xlair-dev/controller/v1/firmware/PROTOCOL.md

# Protocol V1

## フレーム形式

長さは常に 36 バイト。1 フレーム内のオフセットは以下の通り：

| Offset | Bytes | Name | Details |
| --- | ----- | --- | --- |
| 0 | 1 | `SYNC` | `0xFF` 固定 |
| 1 | 1 | `SEQ` | `0x00` - `0xFE`。送信予定スロットごとに `mod 255` で増加 |
| 2 | 1 | `VALID` | bit 0..3：各タッチ基板の I2C 読み出し成功。他 bit は 0 |
| 3 | 1 | `BUTTONS` | bit 0..6 は 7 個のボタン、bit 7 は常に 0。未接続は 0 |
| 4-35 | 32 | `SENSORS` | それぞれ `0x00` - `0xFE` の 32 電極分 |

- `SYNC` 以外の 35 バイトは必ず `0x00` - `0xFE` とする。
- `SEQ` は周期的な送信機会ごとに増える。送信バッファ不足などでフレームを送らなかった場合も進めるため、受信側は抜けた送信機会を推定できる。再起動時は `0` から始めてよい。
- フレームの境界は、`SYNC`、長さ 36 バイトで確定する。

## SENSORS

電極値は、CY8CMBR3108 の Difference Count を `uint8_t` に収めて送る。
各 CY8CMBR3108 は事前に 8 チャネルをボタンセンサーとして設定する。
`254` との min を取るなりして元データの `255` は `254` に丸める。

### 配置と順序

縦方向優先で、1 列につき「上 → 下」の順に番号を振る。

```
00  02  04  06  08  10  12  14  16  18  20  22  24  26  28  30
01  03  05  07  09  11  13  15  17  19  21  23  25  27  29  31
```

| 基板 | I2C address | `SENSORS` のインデックス | 列 |
| --- | --- | --- | --- |
| Slider 1 | `0x37` | `0..7` | `0..3` |
| Slider 2 | `0x38` | `8..15` | `4..7` |
| Slider 3 | `0x39` | `16..23` | `8..11`  |
| Slider 4 | `0x3A` | `24..31` | `12..15` |

各基板の 8 電極は同じ配線で、物理順 E1..E8 はそれぞれ CS3, CS2, CS7, CS6, CS4, CS5, CS0, CS1 に対応する。

### VALID

| Bit | 基板 | 対応アドレス |
| --: | --- | --- |
| 0 | Slider 1 | `0x37` |
| 1 | Slider 2 | `0x38` |
| 2 | Slider 3 | `0x39` |
| 3 | Slider 4 | `0x3A` |

- ビット `1`：フレームに使ったその基板の直近の I2C 読み出しと `SYNC_COUNTER0/1` の一致確認が成功した。
- ビット `0`：読み出しまたは一致確認に失敗した、またはまだ一度も成功していない。同期カウンタ不一致時のみ、その周期で1回再読する。再読も失敗した場合は次の周期で読み直す。
- 失敗した基板の 8 個の `SENSORS` は すべて `0` にする。PC は `VALID = 0` の領域を「非タッチ」と解釈してはならない。
- `VALID = 1` は IC 内部で新しい測定が完了したことを保証しない。読み出しが成功しても、前回と同じ測定値が返ることがある。

## BUTTONS

1 が押下中、0 が解放中。
電気的な active-low / active-high の違いは Pico 側で吸収する。

| Bit | 割り当て |
| --: | --- |
| 0 | ゲームボタン 0 |
| 1 | ゲームボタン 1 |
| 2 | ゲームボタン 2 |
| 3 | ゲームボタン 3 |
| 4 | メンテナンスボタン 0 |
| 5 | メンテナンスボタン 1 |
| 6 | メンテナンスボタン 2 |
| 7 | 常に 0 |

## 送信タイミング

- v1 の初期実装は約 5 ms ごとに最新の状態を 1 フレーム送信する。
- タッチ IC 4 枚は I2C で読み出し、ボタンは GPIO で取得する。
- USB 出力が詰まった場合は状態をキューに積み上げない。最新状態を優先し、途中のフレームは破棄してよい。
