xlair-dev/controller/v1/kicad-lib/3dmodels/WS2812B-4020.step

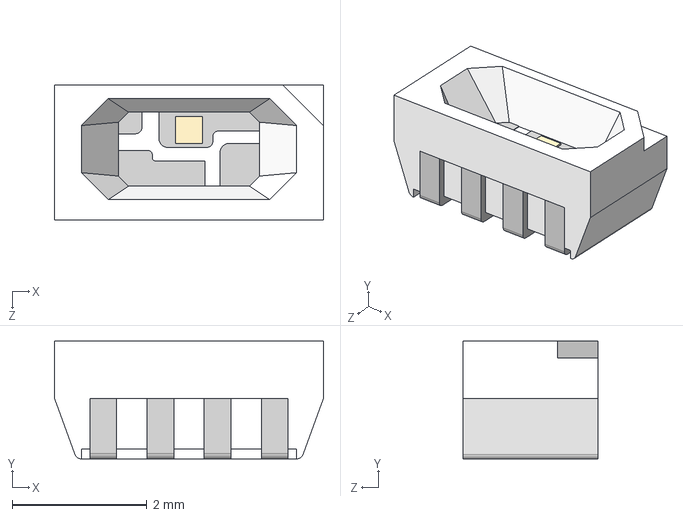
[picture p1: CAD file, 2026-08-24, an earlier design]
v1/kicad-lib/3dmodels/WS2812B-4020.step
4.00 x 1.75 x 2.00 mm
