xlair-dev/controller/v1/pcb/v1.kicad_pcb

## KiCad design v1/pcb/v1.kicad_pcb (2026-10-13, an earlier design)

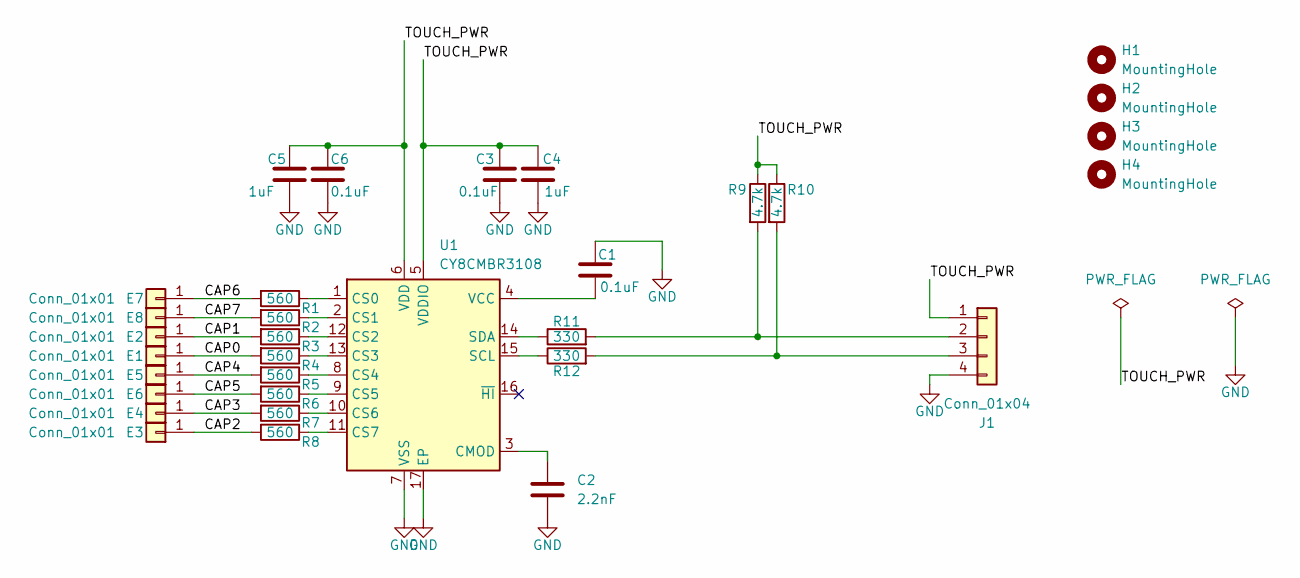
[picture p2: schematic v1.kicad_sch]

Parts:
C1, C3, C5: 0.1uF; C_0603_1608Metric
C2: 2.2nF; C_0603_1608Metric
C4, C6: 1uF; C_0603_1608Metric
E1, E2, E3, E4, E5, E6, E7, E8: Conn_01x01; TouchPad
H1, H2, H3, H4: MountingHole; MountingHole_3.2mm_M3
J1: Conn_01x04; JST_XH_B4B-XH-A_1x04_P2.50mm_Vertical
R1, R2, R3, R4, R5, R6, R7, R8: 560; R_0603_1608Metric
R9, R10: 4.7k; R_Axial_DIN0207_L6.3mm_D2.5mm_P10.16mm_Horizontal
R11, R12: 330; R_0603_1608Metric
U1: CY8CMBR3108; QFN-16-1EP_3x3mm_P0.5mm_EP1.7x1.7mm

Connections:
/CAP0: E1.1 (Pin_1_1), R4.2
/CAP1: E2.1 (Pin_1_1), R3.2
/CAP2: E3.1 (Pin_1_1), R8.2
/CAP3: E4.1 (Pin_1_1), R7.2
/CAP4: E5.1 (Pin_1_1), R5.2
/CAP5: E6.1 (Pin_1_1), R6.2
/CAP6: E7.1 (Pin_1_1), R1.2
/CAP7: E8.1 (Pin_1_1), R2.2
/TOUCH_PWR: C3.1, C4.1, C5.1, C6.1, J1.1, R9.1, R10.1, U1.5 (VDDIO), U1.6 (VDD)
GND: C1.1, C2.2, C3.2, C4.2, C5.2, C6.2, J1.4, U1.7 (VSS), U1.17 (EP)
unnamed: J1.2, R9.2, R11.2
unnamed: J1.3, R10.2, R12.2
unnamed: C2.1, U1.3 (CMOD)
unnamed: R1.1, U1.1 (CS0)
unnamed: R2.1, U1.2 (CS1)
unnamed: R3.1, U1.12 (CS2)
unnamed: R4.1, U1.13 (CS3)
unnamed: R5.1, U1.8 (CS4)
unnamed: R6.1, U1.9 (CS5)
unnamed: R7.1, U1.10 (CS6)
unnamed: R8.1, U1.11 (CS7)
unnamed: R12.1, U1.15 (SCL)
unnamed: R11.1, U1.14 (SDA)
unnamed: C1.2, U1.4 (VCC)

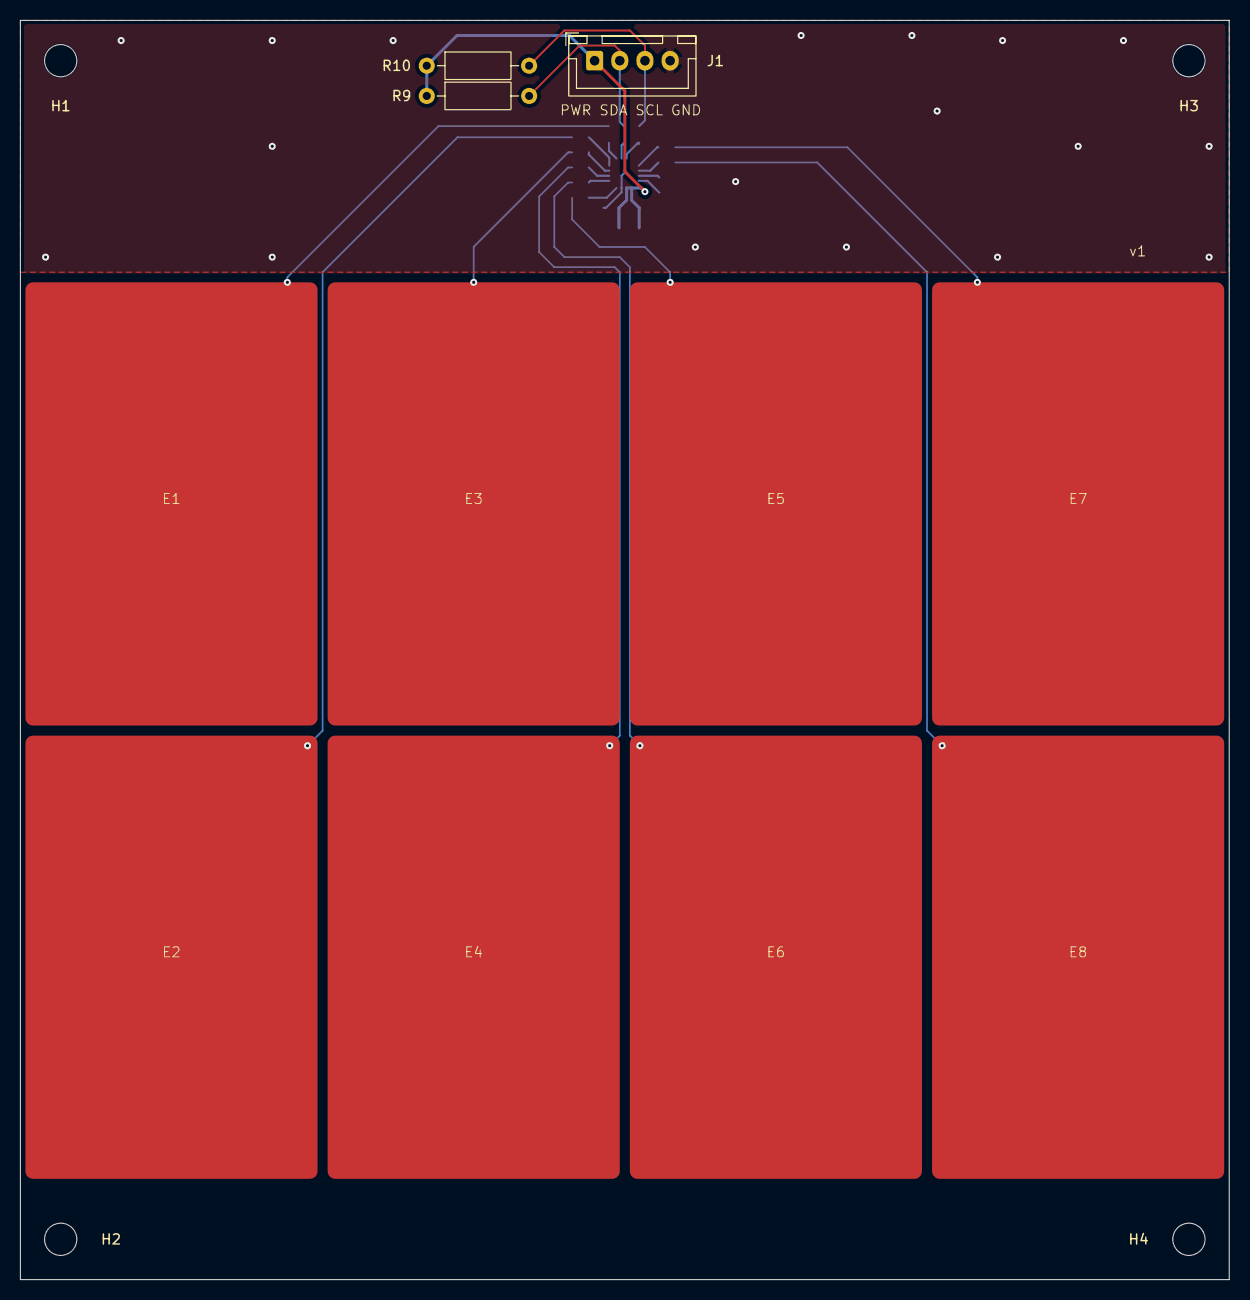
[picture p3: board v1.kicad_pcb from above]

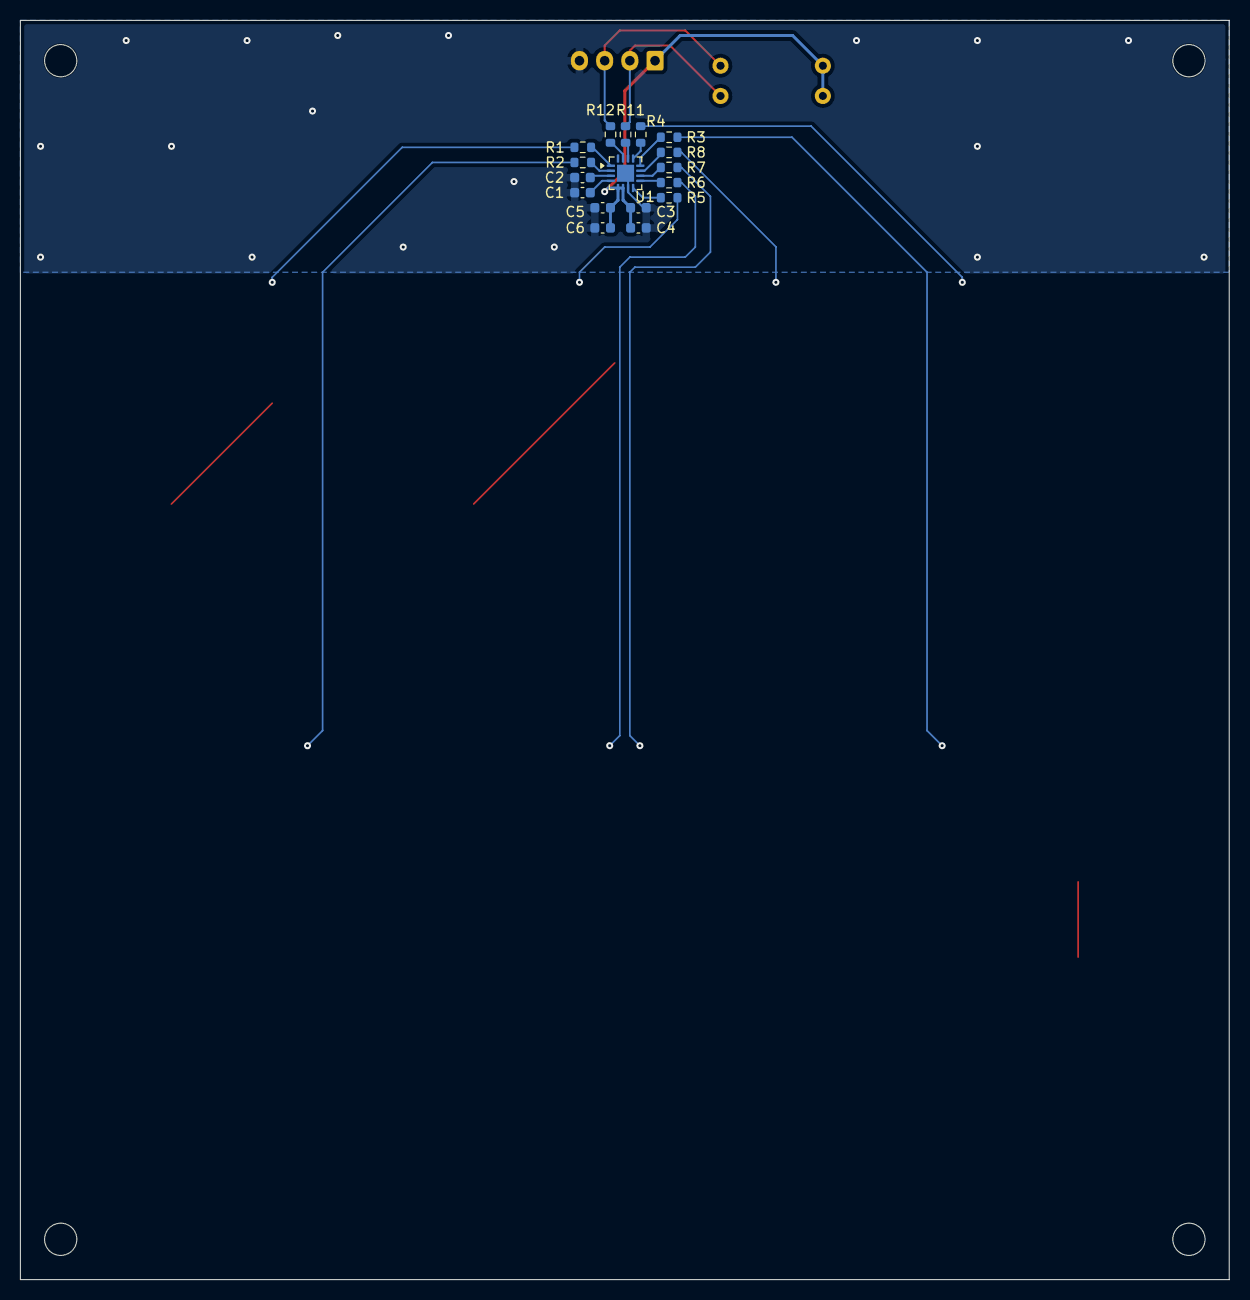
[picture p4: board v1.kicad_pcb from below]

Board: 2 copper layers, 120.0 x 125.0 mm, 32 parts (17 on the bottom side), 24 nets.
