xlair-dev/controller/v2/pcb/v2.kicad_sch

## KiCad design v2/pcb/v2.kicad_sch (2026-10-13)

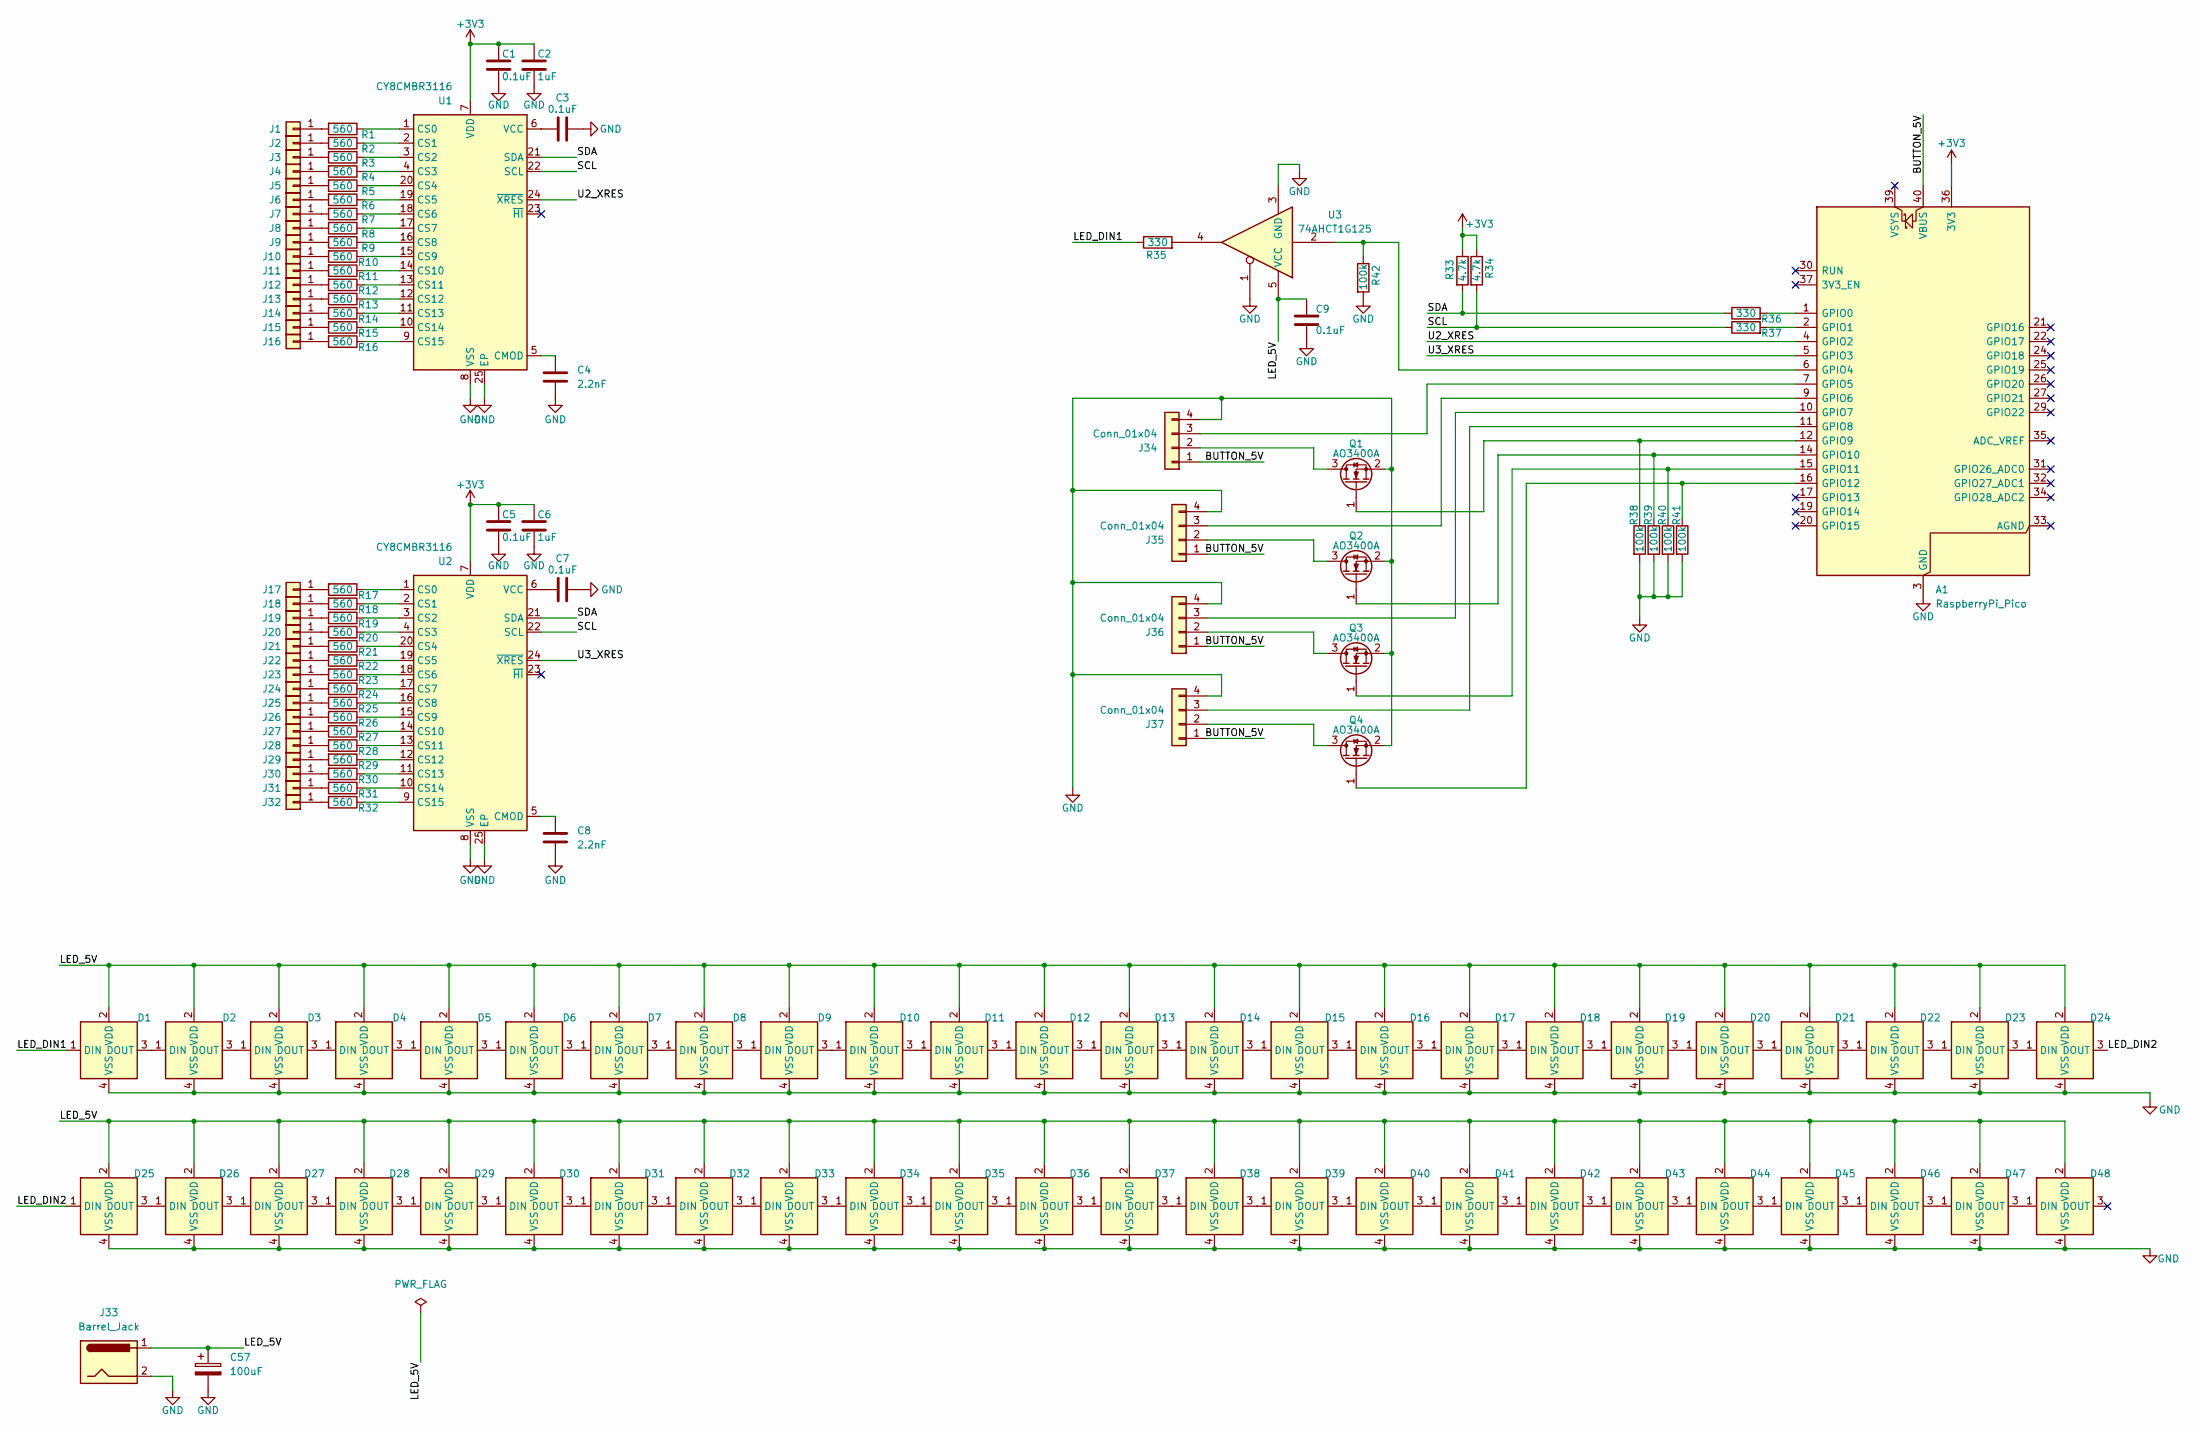
[picture p5: schematic v2.kicad_sch]

Parts:
A1: RaspberryPi_Pico; RaspberryPi_Pico_Common_Unspecified
C1, C3, C5, C7, C9: 0.1uF; C_0603_1608Metric
C2, C6: 1uF; C_0603_1608Metric
C4, C8: 2.2nF; C_0603_1608Metric
C57: 100uF; CP_Elec_6.3x5.4
D1, D2, D3, D4, D5, D6, D7, D8, D9, D10, D11, D12, D13, D14, D15, D16, D17, D18, D19, D20, D21, D22, D23, D24, D25, D26, D27, D28, D29, D30, D31, D32, D33, D34, D35, D36, D37, D38, D39, D40, D41, D42, D43, D44, D45, D46, D47, D48: WS2812B-4020-V6
J1, J2, J3, J4, J5, J6, J7, J8, J9, J10, J11, J12, J13, J14, J15, J16, J17, J18, J19, J20, J21, J22, J23, J24, J25, J26, J27, J28, J29, J30, J31, J32: Conn_01x01
J33: Barrel_Jack
J34, J35, J36, J37: Conn_01x04; JST_XH_B4B-XH-A_1x04_P2.50mm_Vertical
Q1, Q2, Q3, Q4: AO3400A; SOT-23
R1, R2, R3, R4, R5, R6, R7, R8, R9, R10, R11, R12, R13, R14, R15, R16, R17, R18, R19, R20, R21, R22, R23, R24, R25, R26, R27, R28, R29, R30, R31, R32: 560; R_0603_1608Metric
R33, R34: 4.7k; R_0603_1608Metric
R35, R36, R37: 330; R_0603_1608Metric
R38, R39, R40, R41, R42: 100k; R_0603_1608Metric
U1, U2: CY8CMBR3116; QFN-24-1EP_4x4mm_P0.5mm_EP2.6x2.6mm
U3: 74AHCT1G125; SOT-23-5

Connections:
+3V3: A1.36 (3V3), C1.1, C2.1, C5.1, C6.1, R33.1, R34.1, U1.7 (VDD), U2.7 (VDD)
BUTTON_5V: A1.40 (VBUS), J34.1, J35.1, J36.1, J37.1
GND: A1.3 (GND), A1.8 (GND), A1.13 (GND), A1.18 (GND), A1.23 (GND), A1.28 (GND), A1.38 (GND), C1.2, C2.2, C3.2, C4.2, C5.2, C6.2, C7.2, C8.2, C9.2, C57.2, D1.4 (VSS), D2.4 (VSS), D3.4 (VSS), D4.4 (VSS), D5.4 (VSS), D6.4 (VSS), D7.4 (VSS), D8.4 (VSS), D9.4 (VSS), D10.4 (VSS), D11.4 (VSS), D12.4 (VSS), D13.4 (VSS), D14.4 (VSS), D15.4 (VSS), D16.4 (VSS), D17.4 (VSS), D18.4 (VSS), D19.4 (VSS), D20.4 (VSS), D21.4 (VSS), D22.4 (VSS), D23.4 (VSS), D24.4 (VSS), D25.4 (VSS), D26.4 (VSS), D27.4 (VSS), D28.4 (VSS), D29.4 (VSS), D30.4 (VSS), D31.4 (VSS), D32.4 (VSS), D33.4 (VSS), D34.4 (VSS), D35.4 (VSS), D36.4 (VSS), D37.4 (VSS), D38.4 (VSS), D39.4 (VSS), D40.4 (VSS), D41.4 (VSS), D42.4 (VSS), D43.4 (VSS), D44.4 (VSS), D45.4 (VSS), D46.4 (VSS), D47.4 (VSS), D48.4 (VSS), J33.2, J34.4, J35.4, J36.4, J37.4, Q1.2 (S), Q2.2 (S), Q3.2 (S), Q4.2 (S), R38.2, R39.2, R40.2, R41.2, R42.2, U1.8 (VSS), U1.25 (EP), U2.8 (VSS), U2.25 (EP), U3.1, U3.3 (GND)
LED_5V: C9.1, C57.1, D1.2 (VDD), D2.2 (VDD), D3.2 (VDD), D4.2 (VDD), D5.2 (VDD), D6.2 (VDD), D7.2 (VDD), D8.2 (VDD), D9.2 (VDD), D10.2 (VDD), D11.2 (VDD), D12.2 (VDD), D13.2 (VDD), D14.2 (VDD), D15.2 (VDD), D16.2 (VDD), D17.2 (VDD), D18.2 (VDD), D19.2 (VDD), D20.2 (VDD), D21.2 (VDD), D22.2 (VDD), D23.2 (VDD), D24.2 (VDD), D25.2 (VDD), D26.2 (VDD), D27.2 (VDD), D28.2 (VDD), D29.2 (VDD), D30.2 (VDD), D31.2 (VDD), D32.2 (VDD), D33.2 (VDD), D34.2 (VDD), D35.2 (VDD), D36.2 (VDD), D37.2 (VDD), D38.2 (VDD), D39.2 (VDD), D40.2 (VDD), D41.2 (VDD), D42.2 (VDD), D43.2 (VDD), D44.2 (VDD), D45.2 (VDD), D46.2 (VDD), D47.2 (VDD), D48.2 (VDD), J33.1, U3.5 (VCC)
LED_DIN1: D1.1 (DIN), R35.1
LED_DIN2: D24.3 (DOUT), D25.1 (DIN)
unnamed: A1.1 (GPIO0), R36.2
unnamed: A1.2 (GPIO1), R37.2
unnamed: A1.6 (GPIO4), R42.1, U3.2
unnamed: A1.7 (GPIO5), J34.3
unnamed: A1.9 (GPIO6), J35.3
unnamed: A1.10 (GPIO7), J36.3
unnamed: A1.11 (GPIO8), J37.3
unnamed: A1.12 (GPIO9), Q1.1 (G), R38.1
unnamed: A1.14 (GPIO10), Q2.1 (G), R39.1
unnamed: A1.15 (GPIO11), Q3.1 (G), R40.1
unnamed: A1.16 (GPIO12), Q4.1 (G), R41.1
unnamed: C3.1, U1.6 (VCC)
unnamed: C4.1, U1.5 (CMOD)
unnamed: C7.1, U2.6 (VCC)
unnamed: C8.1, U2.5 (CMOD)
unnamed: D1.3 (DOUT), D2.1 (DIN)
unnamed: D2.3 (DOUT), D3.1 (DIN)
unnamed: D3.3 (DOUT), D4.1 (DIN)
unnamed: D4.3 (DOUT), D5.1 (DIN)
unnamed: D5.3 (DOUT), D6.1 (DIN)
unnamed: D6.3 (DOUT), D7.1 (DIN)
unnamed: D7.3 (DOUT), D8.1 (DIN)
unnamed: D8.3 (DOUT), D9.1 (DIN)
unnamed: D9.3 (DOUT), D10.1 (DIN)
unnamed: D10.3 (DOUT), D11.1 (DIN)
unnamed: D11.3 (DOUT), D12.1 (DIN)
unnamed: D12.3 (DOUT), D13.1 (DIN)
unnamed: D13.3 (DOUT), D14.1 (DIN)
unnamed: D14.3 (DOUT), D15.1 (DIN)
unnamed: D15.3 (DOUT), D16.1 (DIN)
unnamed: D16.3 (DOUT), D17.1 (DIN)
unnamed: D17.3 (DOUT), D18.1 (DIN)
unnamed: D18.3 (DOUT), D19.1 (DIN)
unnamed: D19.3 (DOUT), D20.1 (DIN)
unnamed: D20.3 (DOUT), D21.1 (DIN)
unnamed: D21.3 (DOUT), D22.1 (DIN)
unnamed: D22.3 (DOUT), D23.1 (DIN)
unnamed: D23.3 (DOUT), D24.1 (DIN)
unnamed: D25.3 (DOUT), D26.1 (DIN)
unnamed: D26.3 (DOUT), D27.1 (DIN)
unnamed: D27.3 (DOUT), D28.1 (DIN)
unnamed: D28.3 (DOUT), D29.1 (DIN)
unnamed: D29.3 (DOUT), D30.1 (DIN)
unnamed: D30.3 (DOUT), D31.1 (DIN)
unnamed: D31.3 (DOUT), D32.1 (DIN)
unnamed: D32.3 (DOUT), D33.1 (DIN)
unnamed: D33.3 (DOUT), D34.1 (DIN)
unnamed: D34.3 (DOUT), D35.1 (DIN)
unnamed: D35.3 (DOUT), D36.1 (DIN)
unnamed: D36.3 (DOUT), D37.1 (DIN)
unnamed: D37.3 (DOUT), D38.1 (DIN)
unnamed: D38.3 (DOUT), D39.1 (DIN)
unnamed: D39.3 (DOUT), D40.1 (DIN)
unnamed: D40.3 (DOUT), D41.1 (DIN)
unnamed: D41.3 (DOUT), D42.1 (DIN)
unnamed: D42.3 (DOUT), D43.1 (DIN)
unnamed: D43.3 (DOUT), D44.1 (DIN)
unnamed: D44.3 (DOUT), D45.1 (DIN)
unnamed: D45.3 (DOUT), D46.1 (DIN)
unnamed: D46.3 (DOUT), D47.1 (DIN)
unnamed: D47.3 (DOUT), D48.1 (DIN)
unnamed: J1.1, R1.2
unnamed: J2.1, R2.2
unnamed: J3.1, R3.2
unnamed: J4.1, R4.2
unnamed: J5.1, R5.2
unnamed: J6.1, R6.2
unnamed: J7.1, R7.2
unnamed: J8.1, R8.2
unnamed: J9.1, R9.2
unnamed: J10.1, R10.2
unnamed: J11.1, R11.2
unnamed: J12.1, R12.2
unnamed: J13.1, R13.2
unnamed: J14.1, R14.2
unnamed: J15.1, R15.2
unnamed: J16.1, R16.2
unnamed: J17.1, R17.2
unnamed: J18.1, R18.2
unnamed: J19.1, R19.2
unnamed: J20.1, R20.2
unnamed: J21.1, R21.2
unnamed: J22.1, R22.2
unnamed: J23.1, R23.2
unnamed: J24.1, R24.2
unnamed: J25.1, R25.2
unnamed: J26.1, R26.2
unnamed: J27.1, R27.2
unnamed: J28.1, R28.2
unnamed: J29.1, R29.2
unnamed: J30.1, R30.2
unnamed: J31.1, R31.2
unnamed: J32.1, R32.2
unnamed: J34.2, Q1.3 (D)
unnamed: J35.2, Q2.3 (D)
unnamed: J36.2, Q3.3 (D)
unnamed: J37.2, Q4.3 (D)
unnamed: R1.1, U1.1 (CS0)
unnamed: R2.1, U1.2 (CS1)
unnamed: R3.1, U1.3 (CS2)
unnamed: R4.1, U1.4 (CS3)
unnamed: R5.1, U1.20 (CS4)
unnamed: R6.1, U1.19 (CS5)
unnamed: R7.1, U1.18 (CS6)
unnamed: R8.1, U1.17 (CS7)
unnamed: R9.1, U1.16 (CS8)
unnamed: R10.1, U1.15 (CS9)
unnamed: R11.1, U1.14 (CS10)
unnamed: R12.1, U1.13 (CS11)
unnamed: R13.1, U1.12 (CS12)
unnamed: R14.1, U1.11 (CS13)
unnamed: R15.1, U1.10 (CS14)
unnamed: R16.1, U1.9 (CS15)
unnamed: R17.1, U2.1 (CS0)
unnamed: R18.1, U2.2 (CS1)
unnamed: R19.1, U2.3 (CS2)
unnamed: R20.1, U2.4 (CS3)
unnamed: R21.1, U2.20 (CS4)
unnamed: R22.1, U2.19 (CS5)
unnamed: R23.1, U2.18 (CS6)
unnamed: R24.1, U2.17 (CS7)
unnamed: R25.1, U2.16 (CS8)
unnamed: R26.1, U2.15 (CS9)
unnamed: R27.1, U2.14 (CS10)
unnamed: R28.1, U2.13 (CS11)
unnamed: R29.1, U2.12 (CS12)
unnamed: R30.1, U2.11 (CS13)
unnamed: R31.1, U2.10 (CS14)
unnamed: R32.1, U2.9 (CS15)
unnamed: R35.2, U3.4
SCL: R34.2, R37.1, U1.22 (SCL), U2.22 (SCL)
SDA: R33.2, R36.1, U1.21 (SDA), U2.21 (SDA)
U2_XRES: A1.4 (GPIO2), U1.24 (~XRES)
U3_XRES: A1.5 (GPIO3), U2.24 (~XRES)
