xlair-dev/controller/(commit log)

2026-08-24 feat: add kicad project
    [v1_slider.kicad_pcb, v1_slider.kicad_sch]
2026-08-24 feat: add XIAO-RP2040 and unified project
    [v1_unified.kicad_pcb, v1_unified.kicad_sch]
2026-08-24 feat: impl unified slider
    [v1_unified.kicad_sch]
2026-08-24 feat: add WS2812B-4020-V6 footprint
2026-08-24 feat: add 3dmodel and tweak symbols
    [WS2812B-4020.step]
2026-08-24 feat: add LED
    [v1_unified.kicad_sch]
2026-08-25 feat: Pico にする＆DCジャックから電源を取るように
    [v1_unified.kicad_sch]
2026-08-25 feat: assign footprint
    [v1_unified.kicad_sch]
2026-08-25 feat: 0.1uF いらない
    [v1_unified.kicad_sch]
2026-08-25 feat: impl slider sch
    [v1_slider.kicad_sch]
2026-08-27 feat: wip
    [v1_slider.kicad_pcb, v1_slider.kicad_sch, v1_unified.kicad_sch]
2026-08-28 faet: 配線
    [v1_slider.kicad_pcb, v1_slider.kicad_sch]
2026-08-28 feat: ok v1_slider
    [v1_slider.kicad_pcb, v1_slider.kicad_sch]
2026-10-13 refactor: organize PCB and firmware by revision
2026-10-27 feat: impl side-buttons
